MoeHussein/Basira/submission/README.md

# MEDATHON 2026 submission: team MED-VF7H45

| File | What it is |
|---|---|
| `MED-VF7H45_BASIRA_Filter2.pdf` | Pitch deck (Filter 2), 17 slides |
| `MED-VF7H45_BASIRA_demo.mp4` | Demo video, 86 s: the 3D model moving in sync with the app (simulation) |
| `six_views/` | Front, back, left, right, top and bottom views of the digital prototype (renders of the 3D model, not photos) |
| `BASIRA_MED-VF7H45_purchase_list.xlsx` | Components to build the physical prototype: prices, shipping, VAT and customs, 3D-print list |
| `BASIRA_usability_test_kit.pdf` | Script, observer sheet and SUS questionnaire for testing the app with optometrists |
