MoeHussein/Basira/submission/six_views/BASIRA_view_1_front.png

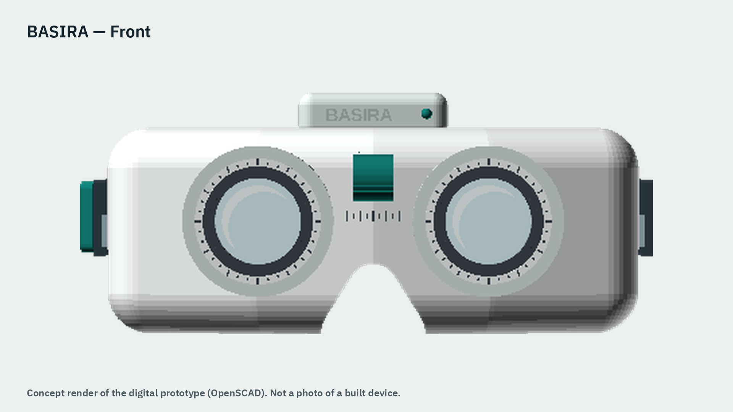
submission/six_views/BASIRA_view_1_front.png
