MoeHussein/Basira/submission/six_views/BASIRA_view_2_back.png

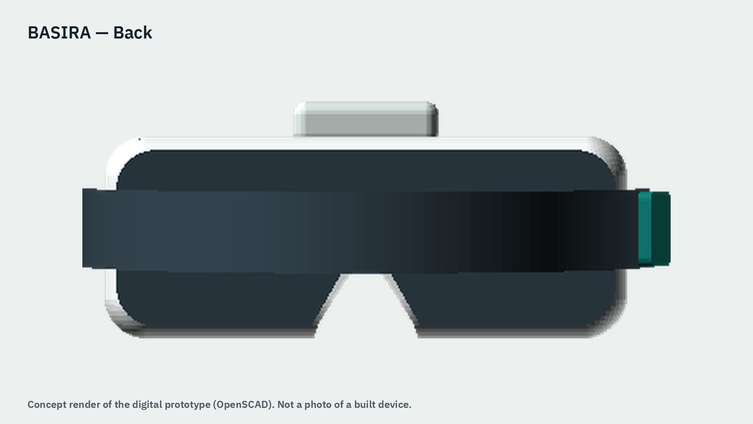
submission/six_views/BASIRA_view_2_back.png
