MoeHussein/Basira/submission/six_views/BASIRA_view_3_left.png

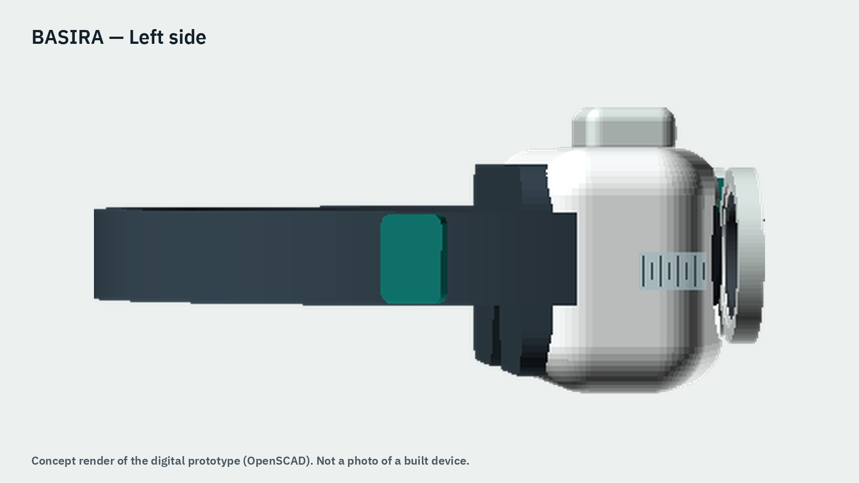
submission/six_views/BASIRA_view_3_left.png
