MoeHussein/Basira/submission/six_views/BASIRA_view_4_right.png

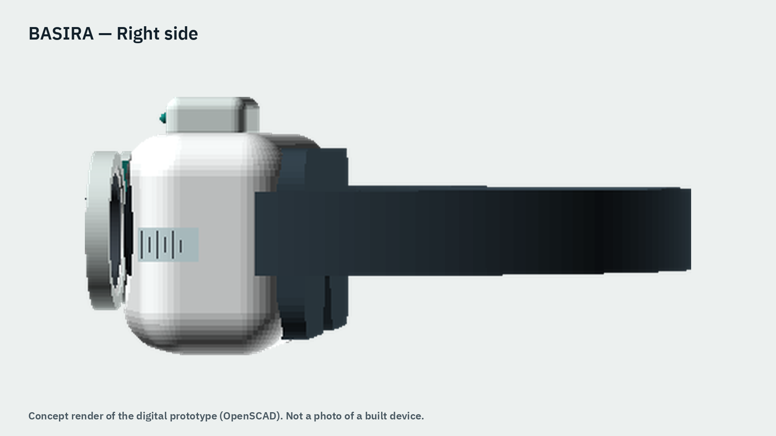
submission/six_views/BASIRA_view_4_right.png
