MoeHussein/Basira/submission/six_views/BASIRA_view_5_top.png

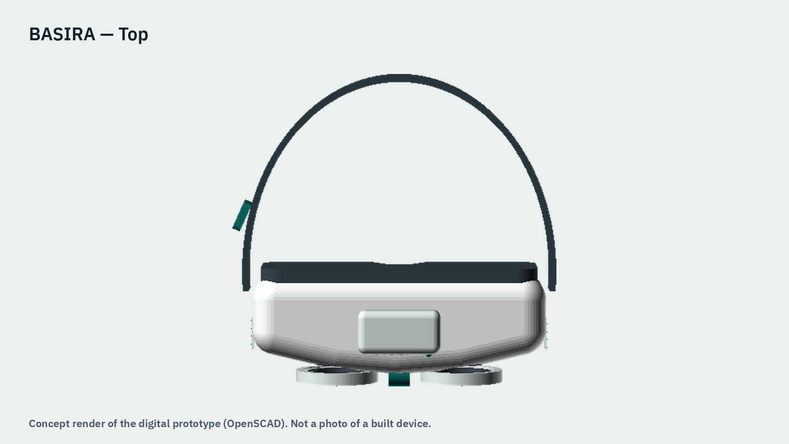
submission/six_views/BASIRA_view_5_top.png
