MoeHussein/Basira/submission/six_views/BASIRA_view_6_bottom.png

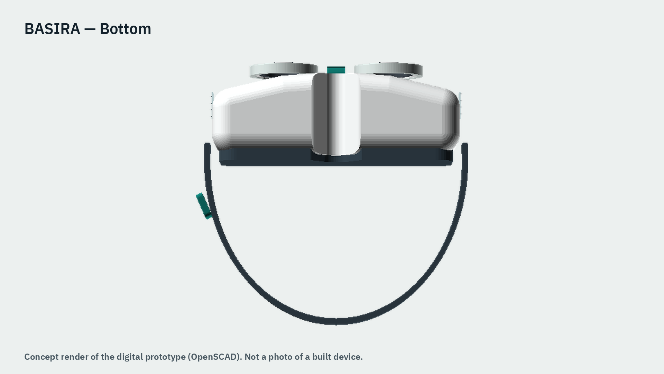
submission/six_views/BASIRA_view_6_bottom.png
