MoeHussein/Basira/submission/BASIRA_MED-VF7H45_purchase_list.xlsx

Sheet: Summary
BASIRA — prototype purchase list (team MED-VF7H45, Track 3: medical tools and devices)
All prices are estimates checked on 11 Nov 2026; confirm with real quotes before ordering. Nothing has been ordered yet.
Cost by phase (parts only) | SAR | USD | What it buys
P1 — optics proof (G1-G2) | 622.5 SAR | $166 | Adjustable glasses for the Alvarez test, caliper, fasteners, filament for the test fixture.
P2 — one motorized eye (G3) | 1604.15 SAR | $427.7733333 | Controller, drivers, 3 motors, 3 sensors, bearings, gears, own cylinder lenses, resin parts.
P3 — second eye + headset (G4-G5) | 1673.825 SAR | $446.3533333 | Repeat of the eye parts, strap, face gasket, second filament spool, second resin batch.
Parts subtotal | 3900.475 SAR | $1040.126667
Shipping (estimates) | 417.5 SAR | $111.3333333 | Per supplier order; see 'Shipping and fees'.
Import VAT 15% + customs fees | 410.13375 SAR | $109.369 | 15% VAT on imported goods + shipping; SAR 15 customs fee per import shipment.
Contingency on parts | 585.07125 SAR | $156.019 | Set in 'Assumptions' (default 15%).
Estimated total budget | 5313.18 SAR | $1416.848
How the work is split
Buy | 22 |  | items in 'Purchase list'
3D print (own printer or service) | 14 |  | parts in '3D print list' (3 are ready to print now)
Borrow | 8 |  | items in 'Borrow and make' (no cost if borrowed)
Make (software / analysis) | 4 |  | work items, no purchase
Not included: lensmeter, trial lens set, printer and power supply are borrowed; team time; regulatory, ethics and clinical-study costs (later, gate G6).

Sheet: Assumptions
BASIRA | MED-VF7H45 — prototype purchase list: assumptions and sources
Prices checked 11 Nov 2026. Blue cells are inputs; change them and every sheet updates. Yellow cells are estimates the team should confirm with a real quote.
Assumption | Value | Source / note
USD to SAR exchange rate | 3.75 | Saudi riyal is pegged at 3.75 per US dollar.
Import VAT rate | 15% | ZATCA: 15% VAT applies to imports regardless of value, on goods + shipping. Source: stackry.com/duties-and-taxes/saudi-arabia; zatca.gov.sa news 1282
Customs processing fee per import shipment (SAR) | 15 | ZATCA: SAR 15 minimum customs declaration fee for online-store shipments. Source: zatca.gov.sa/en/MediaCenter/News/Pages/news-1282.aspx
Customs duty-free threshold per shipment (SAR) | 1000 | Shipments at or below SAR 1,000 incl. shipping are exempt from customs duty (5%). Keep each import order below this. Source: dhl.com/discover/en-sa ... what-is-import-duty
Contingency on parts (spares, breakage, re-orders) | 15% | Team assumption. Prototype builds usually lose a few parts.
Legend
Blue text = input you can edit
Yellow fill = estimate, confirm with a quote
Black text = formula
Green text = pulled from another sheet
Phases
P1 = optics proof without motors (gates G1-G2): cylinder-pair test fixture on a lensmeter, Alvarez plates test.
P2 = one motorized eye (gate G3): 3 drives + 3 angle sensors + occluder + controller + app.
P3 = second eye and headset (gates G4-G5): repeat P2 parts, bridge, strap, face gasket.

Sheet: Purchase list
# | Category | Item | Specification / part number | Route | Supplier (order group) | Qty P1 | Qty P2 | Qty P3 | Total qty | Unit price | Currency | Unit price (SAR) | Line total (SAR) | Price status | Source (checked 11 Nov 2026) | Notes
1 | Optics | Cylinder trial lens +3.00 DC | Glass, 38 mm rim with handle, axis marked | Buy | Good-Lite (USA) or local optical supplier | 0 | 1 | 1 | 2 | 12.95 | USD | 48.5625 SAR | 97.125 SAR | Sourced (similar item) | good-lite.com/products/391012 (individual cylinder trial lens, $12.95) | G1 uses borrowed lenses. Buy own pair for the motorized eye. Check each on a lensmeter and match + / − pairs.
2 | Optics | Cylinder trial lens −3.00 DC | Glass, 38 mm rim with handle, axis marked | Buy | Good-Lite (USA) or local optical supplier | 0 | 1 | 1 | 2 | 12.95 | USD | 48.5625 SAR | 97.125 SAR | Sourced (similar item) | good-lite.com/products/391012 | Same as above. An optical lab can edge the glass round to Ø26 mm for the ring carrier.
3 | Optics | Eyejusters adjustable glasses (SlideLens, sliding-plate type) | Two sliding plates per eye; reading version +0.50 to +4.00 D | Buy | desertcart.sa / Amazon (Eyejusters) | 1 | 0 | 1 | 2 | 70.00 | USD | 262.5 SAR | 525 SAR | Estimate | RRP $59 (engineeringforchange.org); $89.95 (micromark.com). Range +0.50 to +4.00 D (core77.com) | P1: take out one eye's plates for the G2 test. Range is limited; the product needs custom plates (G6). Do NOT buy fluid-filled adjustable glasses.
4 | Optics | Front window disc | Clear acrylic Ø34 × 2 mm, laser cut | Buy | Local (Amazon.sa / laser-cut shop) | 0 | 1 | 1 | 2 | 15.00 | SAR | 15 SAR | 30 SAR | Estimate | — | One per eye; P2 includes a spare.
5 | Electronics | Controller board | Espressif ESP32-S3-DevKitC-1-N8R8 | Buy | Local (Amazon.sa / Noon) | 0 | 1 | 0 | 1 | 25.00 | USD | 93.75 SAR | 93.75 SAR | Sourced (range) | US$15.60 (xonelec.com) to US$31.62 (abra-electronics.com) | One board drives both eyes.
6 | Electronics | Dual DC motor driver | Pololu DRV8833 carrier #2130 (2 motors per board) | Buy | Pololu (USA) | 0 | 2 | 2 | 4 | 10.95 | USD | 41.0625 SAR | 164.25 SAR | Sourced | pololu.com/product/2130 (US$10.95 at qty 1) | 3 boards drive 6 motors; 4th board for the occluder servos' fallback or a spare.
7 | Electronics | Micro metal gearmotor | Pololu 298:1 HPCB 6V #3069, 10 × 12 mm, 9.5 g | Buy | Pololu (USA) | 0 | 4 | 3 | 7 | 24.33 | USD | 91.2375 SAR | 638.6625 SAR | Sourced | pololu.com/product/3069 (US$24.33 each at qty 5+) | 3 per eye (sphere pinion + 2 cylinder rings) + 1 spare. Never stall: gearbox damage.
8 | Electronics | Magnetic angle sensor board | ams OSRAM AS5048A-TS_EK_AB (14-bit, SPI) | Buy | Mouser (USA) | 0 | 4 | 3 | 7 | 18.09 | USD | 67.8375 SAR | 474.8625 SAR | Sourced | Mouser listing via flux.ai (US$18.09); DigiKey €14.39 | One per driven ring/pinion + 1 spare. Sits on a 1:1 sense gear beside each ring.
9 | Electronics | Diametric magnets | Ø6 × 2.5 mm N35, diametrically magnetized, pack of 10 | Buy | AliExpress (import) | 0 | 1 | 0 | 1 | 8.00 | USD | 30 SAR | 30 SAR | Estimate | — | For the sense gears; check the AS5048A board pack for an included magnet first.
10 | Electronics | Micro servo (occluder) | MG90S metal gear, 9 g class | Buy | Local (Amazon.sa / Noon) | 0 | 2 | 1 | 3 | 20.00 | SAR | 20 SAR | 60 SAR | Estimate | — | One per eye + 1 spare.
11 | Electronics | Wiring kit | JST-XH connector kit, silicone wire, jumpers, breadboard, heat-shrink | Buy | Local (Amazon.sa / Noon) | 0 | 1 | 0 | 1 | 90.00 | SAR | 90 SAR | 90 SAR | Estimate | — | Bench harness for P2; reused in P3.
12 | Mechanics | Thin-section ball bearing | 61806-2RS, 30 × 42 × 7 mm | Buy | AliExpress (import) | 0 | 2 | 2 | 4 | 6.45 | USD | 24.1875 SAR | 96.75 SAR | Sourced | zoro.com 61806-2RS (US$6.45) | One per cylinder ring (2 per eye).
13 | Mechanics | Brass gear rack | Module 0.5, 100 × 6 × 6 mm | Buy | AliExpress (import) | 0 | 1 | 1 | 2 | 9.99 | USD | 37.4625 SAR | 74.925 SAR | Sourced | uxcell brass rack 0.5 module 100 × 6 × 6 mm (US$9.99) | Cut into two pieces: one rack per Alvarez plate.
14 | Mechanics | Pinion gear | Module 0.5, 20 T, 3 mm D-bore (fits gearmotor shaft) | Buy | AliExpress (import) | 0 | 3 | 3 | 6 | 9.69 | USD | 36.3375 SAR | 218.025 SAR | Sourced (similar item) | uxcell 0.5 module 20T pinion, 4 mm bore (US$9.69); 3 mm bore variant needed | 3 per eye: sphere pinion + 2 ring drive pinions.
15 | Mechanics | Guide pins and bushings | Ø3 mm stainless dowel pins + brass sleeve bushings kit | Buy | AliExpress (import) | 0 | 1 | 0 | 1 | 12.00 | USD | 45 SAR | 45 SAR | Estimate | — | Metal guides for the Alvarez plates: sideways play must stay ≤ 60 µm (printed slots are not enough).
16 | Mechanics | Screws and nuts | M2 / M3 stainless assortment | Buy | Local (Amazon.sa / Noon) | 1 | 0 | 0 | 1 | 50.00 | SAR | 50 SAR | 50 SAR | Estimate | —
17 | Mechanics | Heat-set threaded inserts | M2 / M3 brass insert kit | Buy | Local (Amazon.sa / Noon) | 1 | 0 | 0 | 1 | 45.00 | SAR | 45 SAR | 45 SAR | Estimate | — | For screws into printed parts.
18 | Mechanics | Small springs | Torsion + compression assortment | Buy | AliExpress (import) | 0 | 1 | 0 | 1 | 8.00 | USD | 30 SAR | 30 SAR | Estimate | — | Pre-load sense gears and racks (removes backlash).
19 | Headset | Head strap with buckle | Replacement VR-headset strap, adjustable | Buy | Local (Amazon.sa / Noon) | 0 | 0 | 1 | 1 | 45.00 | SAR | 45 SAR | 45 SAR | Estimate | — | For the headform tests only; no use on people.
20 | Headset | Face foam gasket | Replacement VR face foam, wipe-clean cover | Buy | Local (Amazon.sa / Noon) | 0 | 0 | 1 | 1 | 40.00 | SAR | 40 SAR | 40 SAR | Estimate | —
21 | Tools | Digital caliper | 150 mm, 0.01 mm resolution | Buy (skip if lab has one) | Local (Amazon.sa / Noon) | 1 | 0 | 0 | 1 | 75.00 | SAR | 75 SAR | 75 SAR | Estimate | — | Needed before any printing: all CAD numbers come from measured parts.
22 | 3D printing | PETG filament | 1.75 mm, 1 kg (Polymaker PolyLite PETG) | Buy | desertcart.sa | 1 | 0 | 1 | 2 | 190.00 | SAR | 190 SAR | 380 SAR | Sourced | desertcart.com.sa Polymaker PolyLite PETG 1 kg (SAR 190) | Frames, covers, bridge, fixtures, dummy headset. Assumes access to a university/lab FDM printer.
23 | 3D printing | Resin printing service (SLA) | Ring carriers with gear teeth, sense gears, plate carriers (see '3D print list') | Print service | Local print service (Jeddah) | 0 | 1 | 1 | 2 | 250.00 | SAR | 250 SAR | 500 SAR | Estimate | — | Get 2-3 quotes by uploading the STL files; price depends on volume, not a fixed rate.
Total parts (before shipping, VAT and contingency) |  |  |  |  |  |  |  |  |  |  |  |  | 3900.475 SAR

Sheet: Shipping and fees
Supplier (order group) | Imported? | Parts subtotal (SAR) | Shipping estimate | Shipping currency | Shipping (SAR) | Import VAT (SAR) | Customs fee (SAR) | Landed cost (SAR) | Below duty-free limit? | Shipping basis / note
Pololu (USA) | Yes | 802.9125 SAR | 35 | USD | 131.25 SAR | 140.124375 SAR | 15 SAR | 1089.286875 SAR | Yes | Estimate: DHL/FedEx international express for a small parcel; Pololu ships worldwide. Confirm at checkout.
Mouser (USA) | Yes | 474.8625 SAR | 25 | USD | 93.75 SAR | 85.291875 SAR | 15 SAR | 668.904375 SAR | Yes | Estimate: international courier for a small parcel. Confirm at checkout.
Good-Lite (USA) or local optical supplier | Yes | 194.25 SAR | 30 | USD | 112.5 SAR | 46.0125 SAR | 15 SAR | 367.7625 SAR | Yes | Estimate. A local optical supplier in Jeddah would avoid shipping and VAT on import.
AliExpress (import) | Yes | 494.7 SAR | 8 | USD | 30 SAR | 78.705 SAR | 15 SAR | 618.405 SAR | Yes | Estimate: AliExpress standard shipping for small items; often free above a basket value.
desertcart.sa / Amazon (Eyejusters) | No | 525 SAR | 0 | SAR | 0 SAR | 0 SAR | 0 SAR | 525 SAR | n/a | desertcart.sa lists free shipping; assumed to include import charges. Confirm at checkout.
desertcart.sa | No | 380 SAR | 0 | SAR | 0 SAR | 0 SAR | 0 SAR | 380 SAR | n/a | Free shipping listed (assumed).
Local (Amazon.sa / Noon) | No | 498.75 SAR | 25 | SAR | 25 SAR | 0 SAR | 0 SAR | 523.75 SAR | n/a | Estimate: local delivery fee if under the free-delivery basket value.
Local (Amazon.sa / laser-cut shop) | No | 30 SAR | 0 | SAR | 0 SAR | 0 SAR | 0 SAR | 30 SAR | n/a | Pick-up or included.
Local print service (Jeddah) | No | 500 SAR | 25 | SAR | 25 SAR | 0 SAR | 0 SAR | 525 SAR | n/a | Estimate: local delivery or pick-up.
Total |  | 3900.475 SAR |  |  | 417.5 SAR | 350.13375 SAR | 60 SAR | 4728.10875 SAR
Check: parts in this table equal the purchase-list total | OK

Sheet: 3D print list
# | Part | Qty (both eyes) | Process | Material | Est. mass each (g) | Est. total (g) | CAD file | Status | Notes
1 | G1 test fixture: base | 1 | FDM | PETG or PLA | 60 | 60 | cad/basira_g1_stokes_fixture.scad (part = base) | Ready: set the 5 measured lens numbers, then export STL | Ø148 mm; check it fits around the lensmeter lens stop.
2 | G1 test fixture: ring 1 (engraved scale) | 1 | FDM | PETG or PLA | 35 | 35 | cad/basira_g1_stokes_fixture.scad (part = ring1) | Ready (same) | Print scale face up, no supports.
3 | G1 test fixture: ring 2 (engraved scale) | 1 | FDM | PETG or PLA | 20 | 20 | cad/basira_g1_stokes_fixture.scad (part = ring2) | Ready (same)
4 | G2 Alvarez test jig (one plate fixed, one on an M3 screw) | 1 | FDM | PETG | 40 | 40 | cad/basira_g2_alvarez_jig.scad | To design after the plates are measured | 0.5 mm per screw turn.
5 | Optical module frame (per eye) | 2 | FDM | PETG | 45 | 90 | To design (Stage 2) | To design after Stage 1 | Holds slide guides, 2 bearings, 3 motors, 3 sensors, occluder hinge.
6 | Cylinder ring carrier with gear teeth | 4 | SLA resin | Tough resin | 8 | 32 | To design (Stage 2) | To design after Stage 1 | Holds a Ø26 mm edged trial lens; teeth printed in resin for precision.
7 | Sense gear 1:1 (magnet holder) | 6 | SLA resin | Tough resin | 2 | 12 | To design (Stage 2) | To design after Stage 1 | Carries the diametric magnet over each AS5048A.
8 | Alvarez plate carrier (with rack seat) | 4 | SLA resin | Tough resin | 4 | 16 | To design (Stage 2) | To design after plates measured
9 | Occluder flap | 2 | FDM | PETG (black) | 4 | 8 | To design (Stage 2) | To design
10 | Bridge with PD slide and lock | 1 | FDM | PETG | 35 | 35 | To design (Stage 3) | To design
11 | Vertex-distance side scale | 2 | FDM | PETG | 5 | 10 | To design (Stage 3) | To design
12 | Outer covers / visor shell | 1 | FDM | PETG | 120 | 120 | cad/basira_exterior_concept.scad (concept only) | Concept exists; real shell after G4 | Shell must be redrawn from measured parts.
13 | Strap buckle (quick release) | 1 | FDM | PETG | 6 | 6 | To design (Stage 3) | To design
14 | Full-size dummy headset (fit, mass, centre of gravity) | 1 | FDM | PLA | 150 | 150 | To design (Stage 3) | To design | Printed before the real shell (gate G4).
Total FDM (g) |  |  |  |  |  | 574
Total resin (g) |  |  |  |  |  | 60
Print settings to send with every STL: FDM 0.4 mm nozzle, 0.2 mm layers, 4 walls, 30% infill; resin 0.05 mm layers. Holes are drawn with 0.3 mm clearance per side; adjust 'clr' in the .scad file, never scale the STL.

Sheet: Borrow and make
Item | Route | From / owner | Needed in phase | Cost if it must be bought (SAR, not in total) | Notes
Trial lens set (with ±3.00 DC cylinders) | Borrow | University of Jeddah optometry clinic (Asmaa) | P1 | 1100 SAR | Half trial set ≈ US$270-292 (good-lite.com). Only borrowed for G1.
Lensmeter (automatic preferred) | Borrow | Optometry clinic | P1-P3 |  | Needed for every calibration session.
Optometrist time (G1, calibration, acceptance limits) | Borrow | Asmaa + supervising optometrist | P1-P3
Current-limited bench power supply | Borrow | KAUST / university lab | P2-P3 | 200 SAR | Buy fallback: 30 V / 5 A bench supply (estimate).
FDM 3D printer | Borrow | University makerspace / lab | P1-P3 |  | Otherwise use a print service (add to purchase list).
Chart display (monitor) at measured distance | Borrow | Any monitor + tape measure | P2-P3
Tablet or laptop for the app | Borrow | Team-owned | P2-P3
Soldering station, multimeter | Borrow | Lab | P2-P3
Firmware (ESP32-S3) | Make | Mohammad | P2 |  | Sensor reading, motor control, state machine, faults.
Bench app + calibration tool (Python) | Make | Mohammad + Muna | P2 |  | Control law, calibration fit, held-out validation, logs.
Clinician tablet app | Make | Mohammad | P3 |  | Exam screen designed; interactive digital prototype built.
Data analysis (repeatability, Bland-Altman) | Make | Muna | P1-P3
