MoeHussein/Basira/calibration/examples/SYNTHETIC_calibration_readings.csv

# SYNTHETIC calibration data generated by calibration/make_synthetic.py - NOT measured on a device
# R.pinion_r_mm=5.0
# R.zero_plate=120.0
# R.sign_plate=1
# R.sign_ringP=1
# R.sign_ringM=-1
# L.pinion_r_mm=5.0
# L.zero_plate=120.0
# L.sign_plate=1
# L.sign_ringP=1
# L.sign_ringM=-1
point | set | eye | raw_plate | raw_ringP | raw_ringM | lens_S | lens_C | lens_ax
R00 | fit | R | 115.089 | 201.518 | 332.716 | -0.32 | -0.69 | 69.0
R01 | fit | R | 121.228 | 226.758 | 285.472 | 1.85 | -2.9 | 104.0
R02 | fit | R | 77.785 | 291.472 | 249.638 | -6.81 | -0.17 | 180.0
R03 | fit | R | 131.918 | 56.698 | 5.4 | 4.86 | -5.32 | 157.0
R04 | fit | R | 88.05 | 87.099 | 10.83 | -2.21 | -6.06 | 170.0
R05 | fit | R | 134.469 | 179.918 | 238.482 | 5.11 | -5.01 | 102.0
R06 | fit | R | 171.324 | 358.449 | 302.478 | 11.46 | -5.19 | 70.0
R07 | fit | R | 75.676 | 275.864 | 144.144 | -4.72 | -5.15 | 16.0
R08 | fit | R | 167.239 | 305.032 | 0.196 | 10.73 | -5.01 | 12.0
R09 | fit | R | 109.421 | 26.294 | 226.604 | 1.26 | -5.7 | 121.0
R10 | fit | R | 77.421 | 119.731 | 347.067 | -4.1 | -5.85 | 18.0
R11 | fit | R | 74.611 | 286.928 | 63.964 | -6.89 | -1.22 | 156.0
R12 | fit | R | 88.1 | 263.482 | 47.148 | -2.84 | -4.75 | 150.0
R13 | fit | R | 96.258 | 349.534 | 289.228 | -0.88 | -5.91 | 73.0
R14 | fit | R | 90.165 | 141.939 | 307.576 | -1.88 | -5.97 | 49.0
R15 | fit | R | 95.071 | 278.168 | 118.424 | -2.31 | -3.45 | 30.0
R16 | fit | R | 77.728 | 209.785 | 87.485 | -4.29 | -5.39 | 102.0
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
L56 | holdout | L | 159.283 | 101.324 | 8.003 | 9.67 | -5.59 | 3.0
L57 | holdout | L | 135.594 | 289.555 | 23.06 | 4.78 | -4.31 | 1.0
L58 | holdout | L | 77.102 | 29.402 | 265.342 | -5.09 | -5.41 | 109.0
L59 | holdout | L | 145.349 | 233.641 | 88.362 | 6.18 | -3.56 | 120.0
