MoeHussein/Basira/validation/examples/SYNTHETIC_clinical_pairs.csv

# SYNTHETIC example generated by validation/clinical_agreement.py --make-example - NOT clinical data
subject | eye | method | session | S | C | ax
S000 | R | reference | 1 | -3.75 | -0.5 | 95
S000 | R | device | 1 | -3.5 | -0.5 | 88
S000 | R | device | 2 | -4.0 | -0.25 | 91
S000 | L | reference | 1 | -1.0 | -0.75 | 121
S000 | L | device | 1 | -1.25 | -0.75 | 111
S000 | L | device | 2 | -0.75 | -0.75 | 124
S001 | R | reference | 1 | 2.25 | -2.0 | 4
S001 | R | device | 1 | 2.25 | -2.0 | 4
S001 | R | device | 2 | 2.0 | -2.0 | 5
S001 | L | reference | 1 | 1.75 | -3.0 | 153
S001 | L | device | 1 | 1.75 | -3.25 | 150
S001 | L | device | 2 | 1.25 | -3.25 | 160
S002 | R | reference | 1 | -2.0 | -0.5 | 94
S002 | R | device | 1 | -1.75 | -0.5 | 97
S002 | R | device | 2 | -1.5 | -0.75 | 97
S002 | L | reference | 1 | -3.25 | -2.0 | 147
S002 | L | device | 1 | -3.5 | -1.75 | 136
S002 | L | device | 2 | -3.5 | -2.25 | 134
S003 | R | reference | 1 | 1.75 | -0.5 | 179
S003 | R | device | 1 | 2.0 | -0.75 | 5
S003 | R | device | 2 | 1.5 | -0.5 | 175
S003 | L | reference | 1 | 1.5 | -1.0 | 73
S003 | L | device | 1 | 1.75 | -1.0 | 69
S003 | L | device | 2 | 1.25 | -1.0 | 75
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
