MoeHussein/Basira/submission/BASIRA_usability_test_kit.pdf

# بروتوكول اختبار قابلية الاستخدام

1.0 .Rev · -001PRO-UT-SIRA | تطبيق الأخصائي لنظام بصيرة — النموذج الأولي الرقمي BA
BASIRA-UT-PRO-001 | الوثيقة رقم
| الإصدار 1.0
| تاريخ الإصدار 13 نوفمبر 2026
| الحالة مسودة للمراجعة
| التصنيف داخلي — فريق المشروع 45H7VF-MED
| المتطلب المرتبط 1U في خطة التحقق والمصادقة )md.VALIDATION_AND_VERIFICATION/docs)
الاعتماد
الدور الاسم التوقيع التاريخ الإعداد محمد حسين
المراجعة السريرية أسماء السباعي مراجعة التحليل منى بايزيد الاعتماد أسماء السباعي، قائدة المشروع سجل المراجعات
الإصدار التاريخ وصف التغيير الُمعّد 1.0 2026-11-13 الإصدار الأول محمد حسين المحتويات

### 1 الغرض 8 إجراء الجلسة 2 النطاق 9 المقاييس ومعايير القبول 3 المراجع 10 معالجة البيانات والتحليل 4 التعاريف 11 السجلات 5 المسؤوليات أ نموذج الملاحظة 01F-UT 6 المشاركون والاعتبارات الأخلاقية ب استبيان SUS 02F-UT 7 المعدات والتجهيز ج سجل المشكلات 03F-UT

نظام بصيرة — بروتوكول اختبار قابلية الاستخدام 1.0 .Rev · -001PRO-UT-BASIRA

داخلي — مسودة للمراجعة صفحة 1 من 8

### .1 الغرض

يحدد هذا البروتوكول طريقة تقييم قابلية استخدام تطبيق الأخصائي في نظام بصيرة مع أخصائيي البصريات، ويجيب عن ثلاثة أسئلة:
.1 هل ُيكمل الأخصائي فحص انكسار كام ًلا للعين الواحدة دون مساعدة؟ .2 ما المشكلات التي تعيق ذلك، وما شّدتها؟ .3 ما تقييم المستخدمين لقابلية الاستخدام على مقياس SUS؟ ُتستعمل النتائج لتحسين التطبيق، ثم ُيعاد الاختبار للتأكد من أن التحسين نجح.

### .2 النطاق

يشمل: تطبيق الأخصائي في وضع المحاكاة، بالإصدار المحفوظ في المستودع )html.app_BASIRA/dist)، مع مريض افتراضي داخل البرنامج.
لا يشمل: فحص أي شخص، أو استعمال الجهاز الفعلي، أو جمع بيانات صحية. ولا يقيس هذا الاختبار دقة الجهاز البصري، فذلك يخضع لإجراءات المعايرة والتحقق )md.CALIBRATION/docs).

### .3 المراجع

| 1 9241-11:2018 ISO، بيئة التفاعل بين الإنسان والنظام — الجزء :11 قابلية الاستخدام، التعاريف والمفاهيم.
Brooke J. SUS: a "quick and dirty" usability scale. In: Usability Evaluation in Industry. Taylor & Francis; 1996. | 2
Nielsen J, Landauer TK. A mathematical model of the finding of usability problems. Proc. INTERCHI '93; 1993. | 3
Sauro J. A Practical Guide to the System Usability Scale. Measuring Usability LLC; 2011. | 4
| 5 وثائق المشروع: خطة التحقق والمصادقة، وسجل التحسينات )md.ITERATIONS/docs).

داخلي — مسودة للمراجعة صفحة 2 من 8

### .4 التعاريف

المصطلح التعريف
المشارك أخصائي البصريات الذي يؤدي المهام، و ُيرمز له 5P…1P. المراقب عضو الفريق الذي يدير الجلسة ويس ّجل الملاحظات ولا يساعد إلا وفق البند .8.4 CONFIRMED حالة الجهاز بعد أن تؤّكد الحّساسات الإعداد. لا ُتحفظ نتيجة قبلها. وصفة البعيد القيمة المؤَّكدة بعد تصحيح ُبعد لوحة القراءة، كما يعرضها التطبيق. أقصى موجب أكثر قيمة موجبة ل لكروي تعطي أفضل حّدة إبصار، وهي نقطة النهاية المعتمدة. SUS مقياس قابلية الاستخدام، من عشرة بنود، ونتيجته من 0 إلى 100 )المرجع 2(. شّدة المشكلة 0 = ليست مشكلة · 1 = شكلية · 2 = بسيطة · 3 = كبيرة · 4 = تمنع إكمال المهمة.

### .5 المسؤوليات

| الدور الشخص المسؤولية
نجاح المهام. | قائدة الاختبار أسماء السباعي دعوة المشاركين، وإدارة الجلسات، والحكم السريري على
| المراقب عضو من الفريق التوقيت وتعبئة النموذج 01F-UT.
| محللة البيانات منى بايزيد إدخال البيانات وتحليلها وإعداد التقرير.
التحسينات. | مسؤول البرمجيات محمد حسين تجهيز الإصدار المخت َبر، وتنفيذ التحسينات، وتحديث سجل

### .6 المشاركون والاعتبارات الأخلاقية

العدد: خمسة مشاركين. هذا العدد يكشف عادة أغلب مشكلات الاستخدام ا لكبيرة )المرجع 3(، لكنه لا يكفي لتعميم درجة SUS.
معايير الإدراج: أخصائي بصريات مرّخص أو متد ّرب امتياز يجري فحص الانكسار. معايير الاستبعاد: أعضاء الفريق، ومن رأى التطبيق قبل الجلسة. الموافقة: ُيقرأ نص الافتتاح )البند 8.2(، و ُتس َّجل الموافقة الشفهية في النموذج 01F-UT. الخصوصية: لا ُتس َّجل الأسماء. ُيحفظ الدور وسنوات الخبرة فقط، ولا ُيس َّجل صوت ولا صورة إلا بموافقة صريحة. الموافقة الأخلاقية: تتحقق قائدة الاختبار من اشتراطات جامعة جدة قبل الجلسة الأولى، و ُيوَّثق القرار في السجلات )البند .)11

### .7 المعدات والتجهيز

.1 حاسوب محمول أو جهاز لوحي يعمل عليه الملف html.app_BASIRA/dist، ولا يحتاج إلى اتصال بالإنترنت.

داخلي — مسودة للمراجعة صفحة 3 من 8

.2 ساعة توقيت، ونسخة مطبوعة من النماذج 01F-UT و02F-UT لكل مشارك. .3 قبل كل جلسة: افتح الملف، واختر »محاكاة« ثم »اتصال«، ثم اختر المريض »حالة ب«. لا ُتظهر الوصفة الحقيقية أمام المشارك.
.4 الوصفة الحقيقية للعين اليمنى )للمراقب فقط(: 90 × −1.25 / ،+1.50 أي مكافئ كروي D .+0.88 .5 القيم التي ُتعطى للمشارك عند طلبها: ُبعد اللوحة 6 م، ومسافة القمة 13 مم، والمسافة بين الحدقتين 63 مم.

### .8 إجراء الجلسة

### 8.1 المدة والترتيب

مدة الجلسة نحو 20 دقيقة، بالترتيب: الافتتاح )دقيقتان(، ثم المهام )12 دقيقة(، ثم الاستبيان والأسئلة )6 دقائق(.

### 8.2 نص الافتتاح

لجهاز فحص انكسار ُيلُيبس على الرأس ويتح ّكم به الأخصائي من التطبيق، والمريض
»شكًرا لوقتك. نختبر التطبيق ولا نختبرك. هذا نموذج رقمي افتراضي، وصورة اللوحة ُتظهر ما يراه. ف ّكر بصوت عاٍل: قل ما تتوّقعه وما يفاجئك. لن أساعدك إلا إذا توّقفت تما ًما. لن نس ّجل اسمك. هل توافق على المشاركة؟«

### 8.3 المهام

| | الرمز نص المهمةكما ُيقرأ معيار النجاح
| | 1T« ابدأ فحص العين اليمنى، واحجب العين اليسرى.« اختار العين اليمنى وحجب اليسرى.
من D .+0.88 | | 2T« جد أفضل قوةكرو ية لهذا المريض.« المكافئ ا لكروي في »وصفة البعيد« ضمن D ±0.25
ضمن ±10° من .90° | | 3T« حّسن الأسطوانة ومحورها بالأسطوانة المتقاطعة.« الأسطوانة ضمن D ±0.25 من D ،−1.25 والمحور
بعد CONFIRMED، ونّزل الملف. | | 4T« احفظ نتيجة العين ونّزل سجل الفحص.« أدخل مسافة القمة والمسافة بين الحدقتين، وحفظ
لاحظ العطل، ولم يحفظ نتيجة غير مؤَّكدة، وأعاد الضبط. | يقول: »تابع الفحص.« | 5T يضغط المراقب »محاكاة: فصل حّساس« أثناء حركة الجهاز، ثم

### 8.4 قواعد التسجيل والمساعدة

ُتس َّجل نتيجةكل مهمة: 1 = نجح دون مساعدة، 0.5 = نجح بمساعدة، 0 = لم ينجح. ُيس َّجل الزمن بالثواني من نهاية قراءة المهمة إلى إعلان المشارك انتهاءه. الخطأ هو فعل يتراجع عنه المشارك أو يقود إلى نتيجة خاطئة. لا يساعد المراقب إلا بعد 60 ثانية من التوقف التام، وبتلميح واحد فقط، و ُيس َّجل التلميح.

### 8.5 الختام

يملأ المشارك الاستبيان 02F-UT بنفسه، ثم يجيب عن الأسئلة المفتوحة في النموذج 01F-UT.

داخلي — مسودة للمراجعة صفحة 4 من 8

### .9 المقاييس ومعايير القبول

| المقياس معيار القبول )حّدده الفريق(
| نسبة النجاح دون مساعدة في 1T و4T و5T 4 من 5 مشاركين أو أكثر في كل مهمة
| دقة الوصفة في 2T و3T 4 من 5 مشاركين أو أكثر ضمن المعيار
معه فاصل الثقة 95 % | متوسط درجة SUS 68 أو أكثر، وهو المتوسط المنشور )المرجع 4(، و ُيذكر
| المشكلات من الشّدة 4 لا شيء بعد جولة التحسين
إذا لم يتحقق معيار، ُيص َلح السبب، ثم ُتعاد المهمة المتأثرة مع مشارَكين جدي َدين على الأقل.

### .10 معالجة البيانات والتحليل

.1 ُتنقل بيانات كل نموذج إلى سطر في الملف csv.results_usability/validation، باستعمال القالب الموجود في المستودع.
درجة | يخرجُ .python3 validation/usability_summary.py validation/usability_results.csv الأمر | غلَّ | يشُ | .2
SUS لكل مشارك، والمتوسط مع فاصل ثقة 95 ،% ونسبة النجاح والزمن الوسيط لكل مهمة. .3 تصحيح SUS( المرجع 2(: البنود الفردية = الإجابة − ،1 والزوجية = 5 − الإجابة، والمجموع × .2.5 .4 ُتجمع المشكلات في النموذج 03F-UT و ُترَّتب حسب الشّدة ثم عدد المشاركين المتأثرين. .5 ُتعالج المشكلات من الشّدة 3 و4 أو ًلا، ثم ُيس َّجل »قبل/بعد« في md.ITERATIONS/docs.

### .11 السجلات

| السجل مكان الحفظ
الفريق | النماذج الورقية 01F-UT و02F-UT ملف ورقي لدى قائدة الاختبار، ونسخة ممسوحة في مجلد
validation/usability_results.csv | المجهولة الجلسات بيانات
| سجل المشكلات 03F-UT والتقرير المستودع، مجلد /validation
| قرار الموافقة الأخلاقية مجلد الفريق

داخلي — مسودة للمراجعة صفحة 5 من 8

### الملحق أ — نموذج الملاحظة 1.0 .Rev · 01F-UT

رمز المشارك: الدور: سنوات الخبرة: التاريخ: المراقب: الموافقة الشفهية: نعم
الزمن )ث( الأخطاء تلميح الملاحظات وأقوال المشارك | 1 / 0.5 / 0 | المهمة النتيجة
| | T1
| | T2
| | T3
| | T4
| | T5

الوصفة النهائية التي وصل إليها المشارك )»وصفة البعيد«(: الأسئلة المفتوحة
.1 ما أكثر ما أعاقك أو أربكك أثناء الفحص؟

.2 هل كان واضًحا الفرق بين القيمة »المطلوبة« والقيمة »المؤَّكدة من الحّساسات«؟

.3 ما الذي ينقص لتستعمله في عيادتك أو في فحص ميداني؟

.4 مقارنة بجهاز Phoropter التقليدي: ما الأفضل، وما الأسوأ؟

.5 ملاحظات أخرى:

داخلي — مسودة للمراجعة صفحة 6 من 8

UT-F02 · Rev. 1.0 | SUS | استبيان — ب الملحق

يملؤه المشارك. الصيغة الإنجليزية الأصلية )المرجع 2( ُتستعمل كما هي؛ وكلمة »system »تعني تطبيق بصيرة. ضع علامة في مربع واحد لكل عبارة.
# | Statement | Strongly disagree 1 | 2 | 3 | 4 | Strongly agree 5

1 | I think that I would like to use this system frequently.
2 | I found the system unnecessarily complex.
3 | I thought the system was easy to use.
4 | I think that I would need the support of a technical person to be able to use this system.
5 | I found the various functions in this system were well integrated.
6 | I thought there was too much inconsistency in this system.
7 | I would imagine that most people would learn to use this system very quickly.
8 | I found the system very cumbersome to use.
9 | I felt very confident using the system.
10 | I needed to learn a lot of things before I could get going with this system.

Participant code: ________ Date: ____________

داخلي — مسودة للمراجعة صفحة 7 من 8

### الملحق ج — سجل المشكلات 1.0 .Rev · 03F-UT

تعّبئه محللة البيانات بعد الجلسات. الشّدة وفق التعريف في البند .4
الاختبار | # المهمة وصف المشكلة المشاركون الشّدة الإجراء نتيجة إعادة
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
BASIRA-UT-PRO-001 الوثيقة | نهاية

داخلي — مسودة للمراجعة صفحة 8 من 8
