MoeHussein/Basira/validation/examples/SYNTHETIC_agreement_output/bland_altman_J0.png

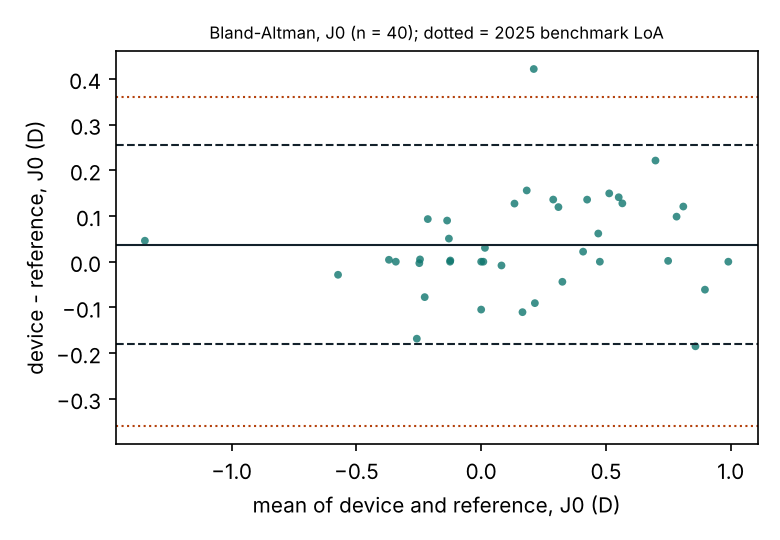
validation/examples/SYNTHETIC_agreement_output/bland_altman_J0.png
