MoeHussein/Basira/validation/examples/SYNTHETIC_agreement_output/bland_altman_J45.png

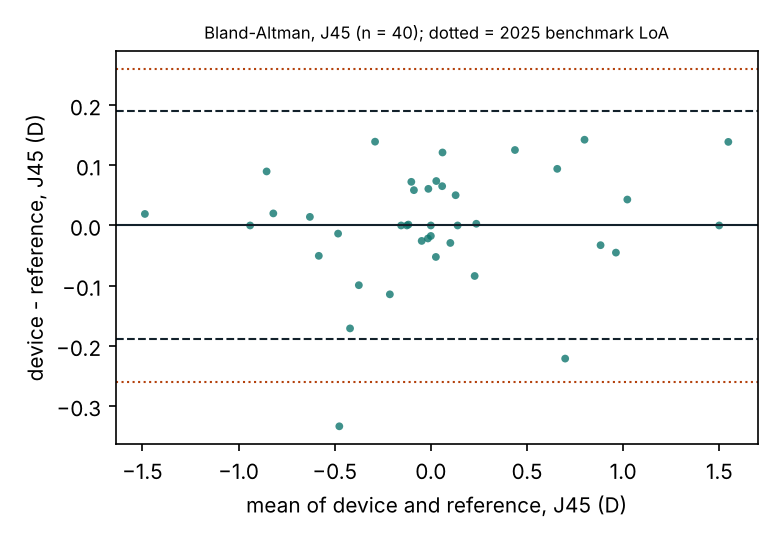
validation/examples/SYNTHETIC_agreement_output/bland_altman_J45.png
