MoeHussein/Basira/validation/examples/SYNTHETIC_agreement_output/bland_altman_M.png

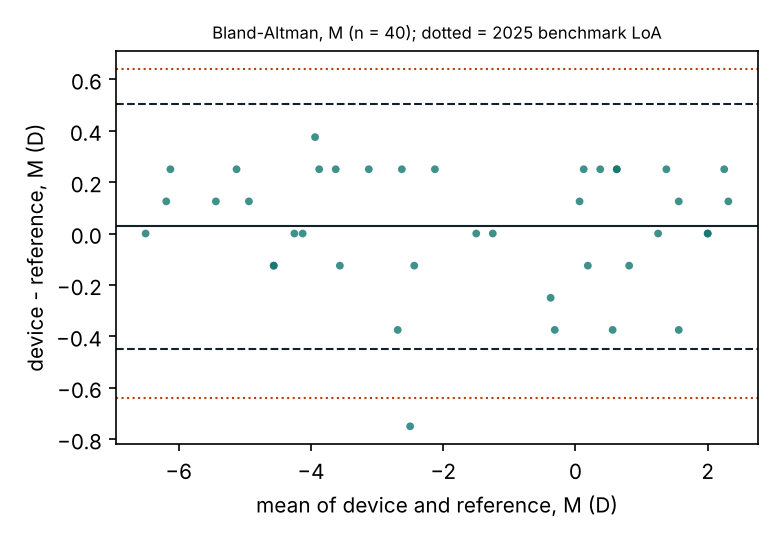
validation/examples/SYNTHETIC_agreement_output/bland_altman_M.png
