MoeHussein/Basira/(commit log)

2026-11-13 Add cad
    [basira_exterior_concept.scad, basira_g1_stokes_fixture.scad]
2026-11-13 Add calibration
2026-11-13 Add calibration/examples
    [SYNTHETIC_calibration_readings.csv]
2026-11-13 Add calibration fit output example
2026-11-13 Add ArduinoJson (third_party)
2026-11-13 Add submission
    [BASIRA_MED-VF7H45_purchase_list.xlsx]
2026-11-13 Add validation
    [usability_results_template.csv]
2026-11-13 Add validation/examples
    [SYNTHETIC_clinical_pairs.csv]
2026-11-13 Fix BASIRA STOP interlock and calibration acceptance
    [calib_model.py, device.cpp, fit_calibration.py, test_main.cpp]
